wridgers/3dpqf/images/chainlink_fence.jpg

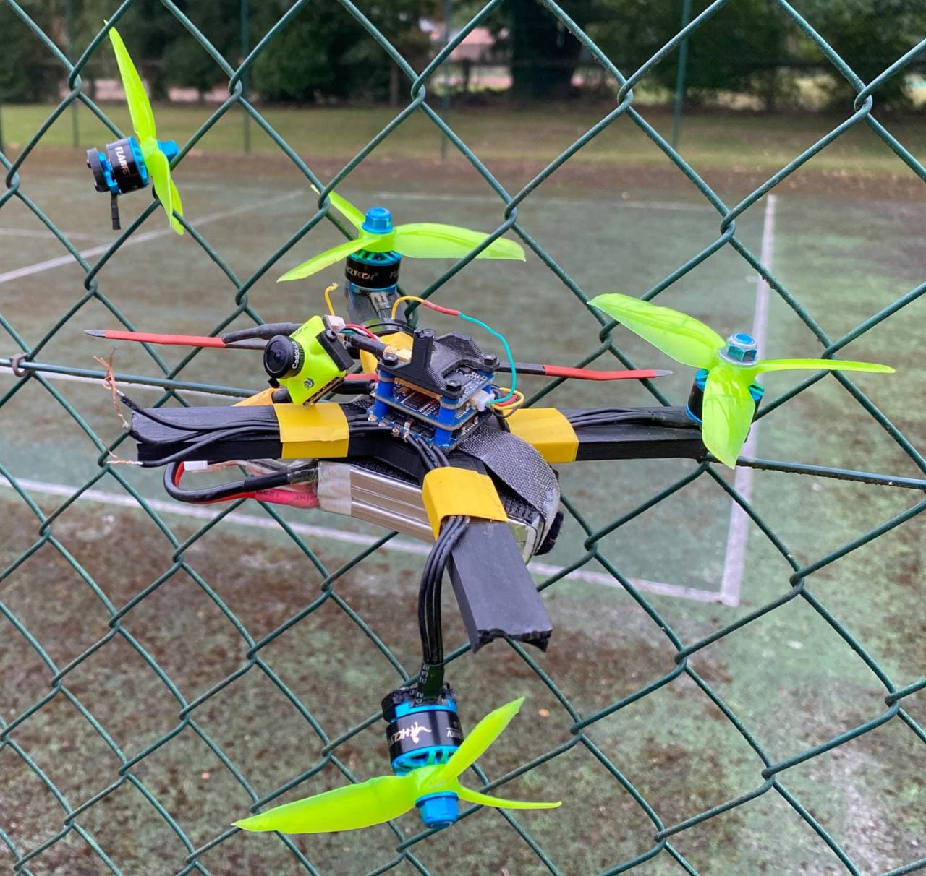
images/chainlink_fence.jpg
