wridgers/3dpqf/parts/20mm_by_20mm_camera_mount.FCStd

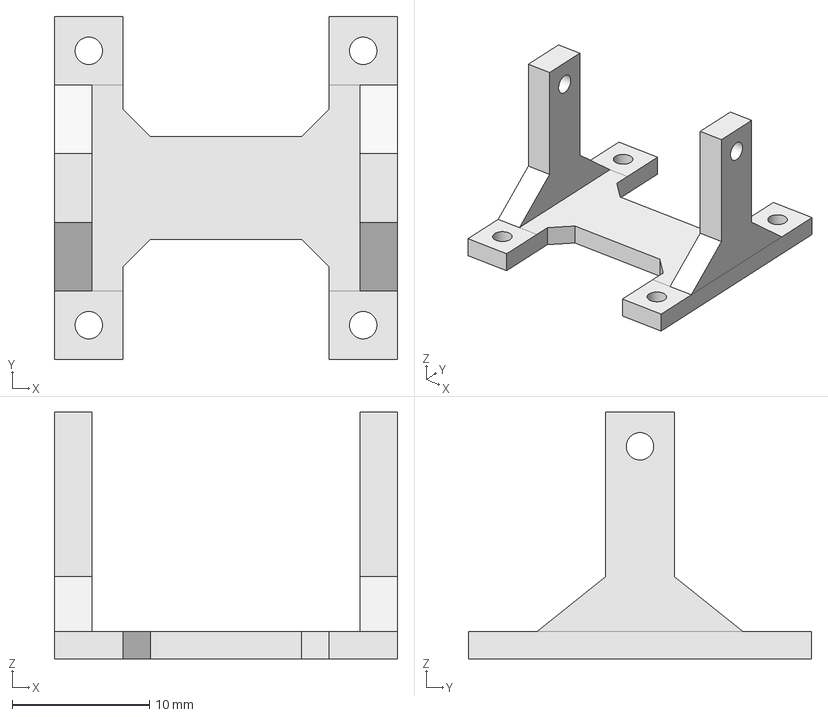
[picture p3: CAD file, 2021-03-13]
parts/20mm_by_20mm_camera_mount.FCStd
25.0 x 25.0 x 18.0 mm
