wridgers/3dpqf/stl/4in_250g.stl

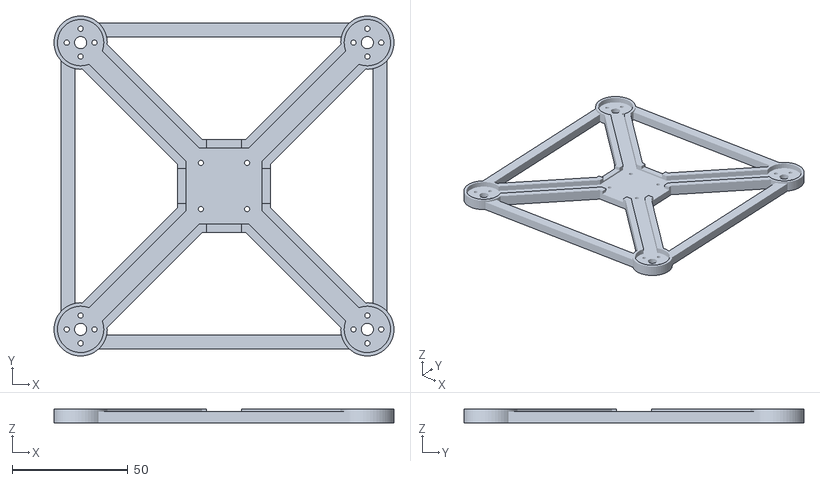
[picture p4: CAD file, 2021-03-17]
stl/4in_250g.stl
146.7 x 146.7 x 6.00
