wridgers/3dpqf/(list of files, cad)

Other CAD files:
stl/20mm_by_20mm_camera_mount.stl
