wridgers/3dpqf/(commit log)

2021-03-13 Add 20x20 stack camera mount
    Designed to sit atop the iFlight SucceX F4 V3 Mini and hold a Caddx Turbo
    Micro F2.
    [20mm_by_20mm_camera_mount.FCStd, 20mm_by_20mm_camera_mount.stl]
2021-03-17 Add missing battery strap slots
    [4in_250g.scad, 4in_250g.stl, frame.scad]
2021-03-17 Update commit for 250g build
    Previous commit was accidentally missing the battery strap slots.
